bpipta/ENCE_3220_Class2023/PhaseD_Prototype/Notes/Hardware_Block_Diagram.pdf

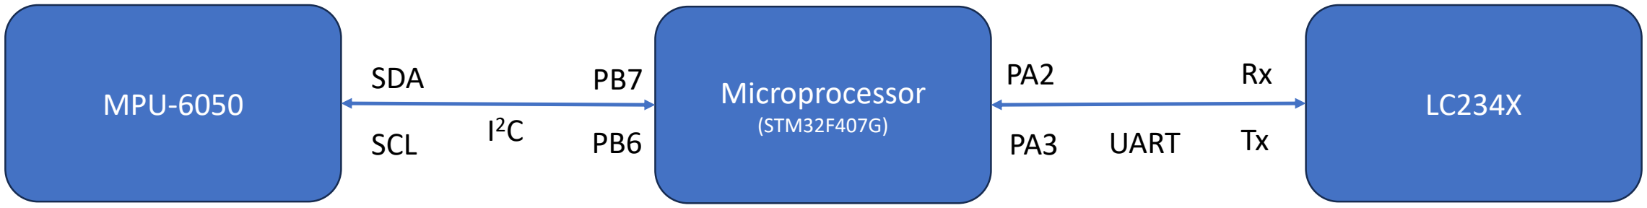
[picture p4: figure]
Microprocessor; (STM32F407G); MPU; SDA; SCL; UART
