bpipta/ENCE_3220_Class2023/PhaseB_Prototype/Notes/Hardware_Block_Diagram.pdf

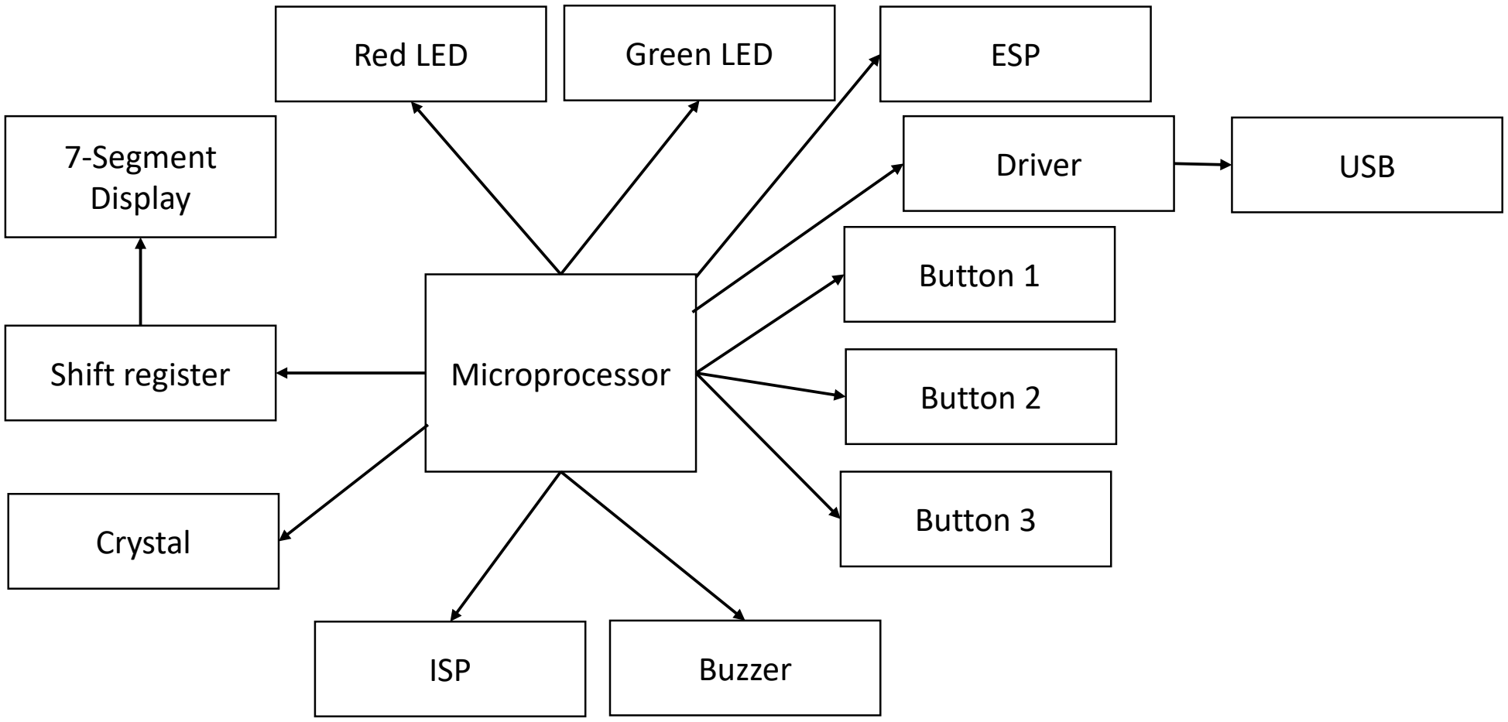
[picture p5: figure]
Microprocessor; 7-Segment Display; Shift register; Red LED; Green LED; Buzzer; Button 1; Button 3; Button 2; ISP; Crystal; ESP; Driver; USB
