bpipta/ENCE_3220_Class2023/PhaseA_Prototype/Notes/Hardware_Block_Diagram.pdf

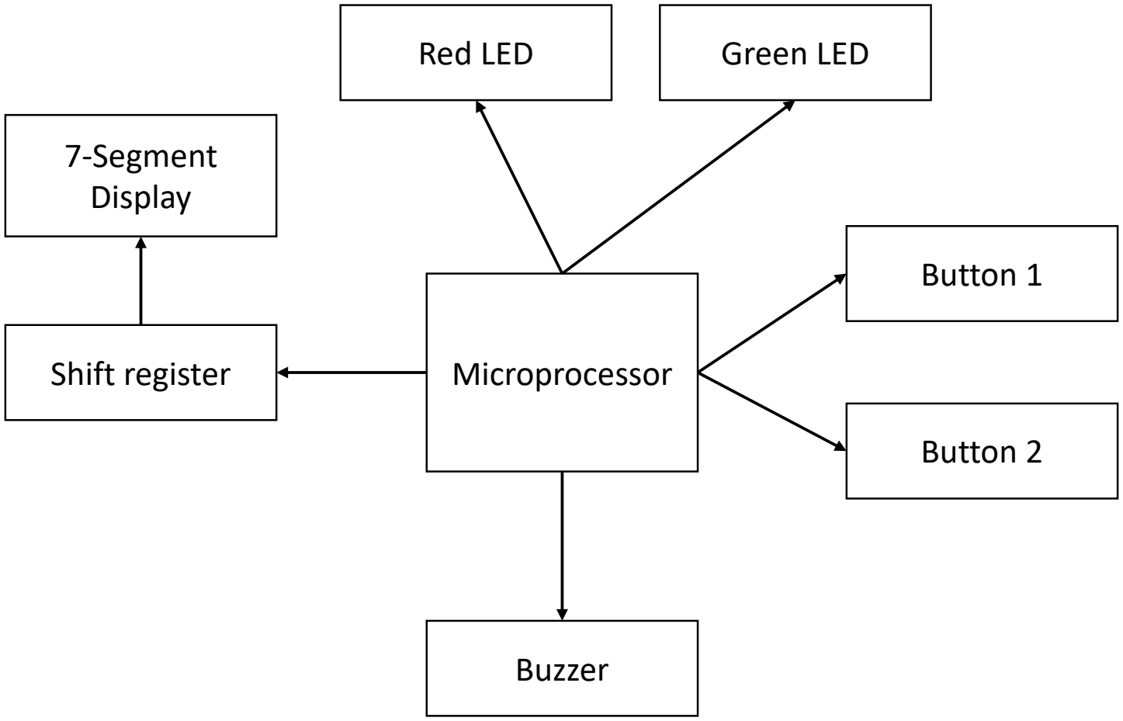
[picture p10: figure]
Microprocessor; 7-Segment Display; Shift register; Red LED; Green LED; Buzzer; Button 1; Button 2
