bpipta/ENCE_3220_Class2023/PhaseB_Prototype/Notes/Code_Block_Diagram.pdf

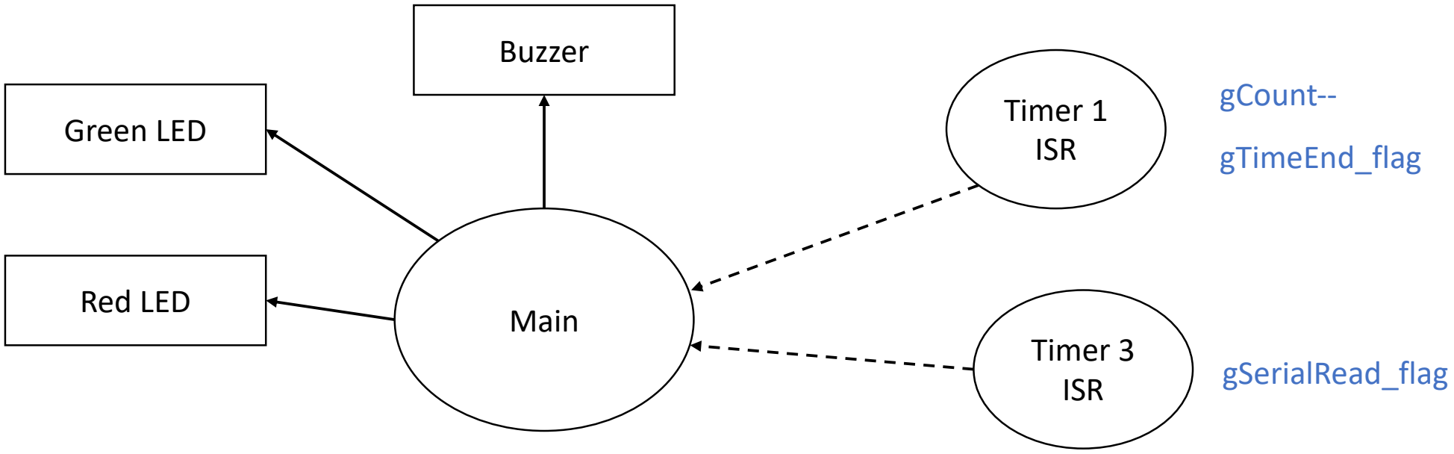
[picture p11: figure]
Main; Timer 1 ISR; Green LED; Red LED; Buzzer; gTimeEnd_flag; gCount--; Timer 3; ISR; gSerialRead_flag

Button 1
ISR

Button 2
ISR

Timer 2
ISR

7 Segment
Display
Start/Stop timer | gCount++
