bpipta/ENCE_3220_Class2023/PhaseD_Prototype/Notes/Software_Block_Diagram.pdf

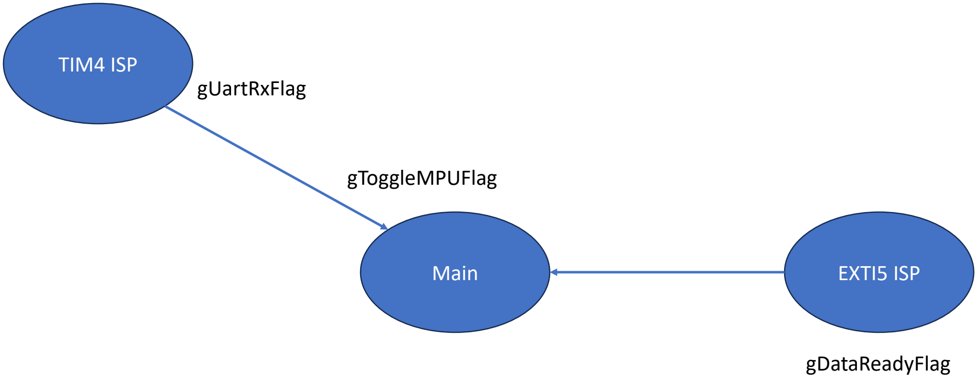
[picture p12: figure]
Main; EXTI5 ISP; TIM4 ISP; gUartRxFlag; gDataReadyFlag; gToggleMPUFlag
