bpipta/ENCE_3220_Class2023/PhaseA_Prototype/Notes/3D_Board.gif

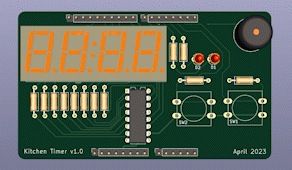
PhaseA_Prototype/Notes/3D_Board.gif
