bpipta/ENCE_3220_Class2023/PhaseA_Prototype/Notes/pcb_layout.png

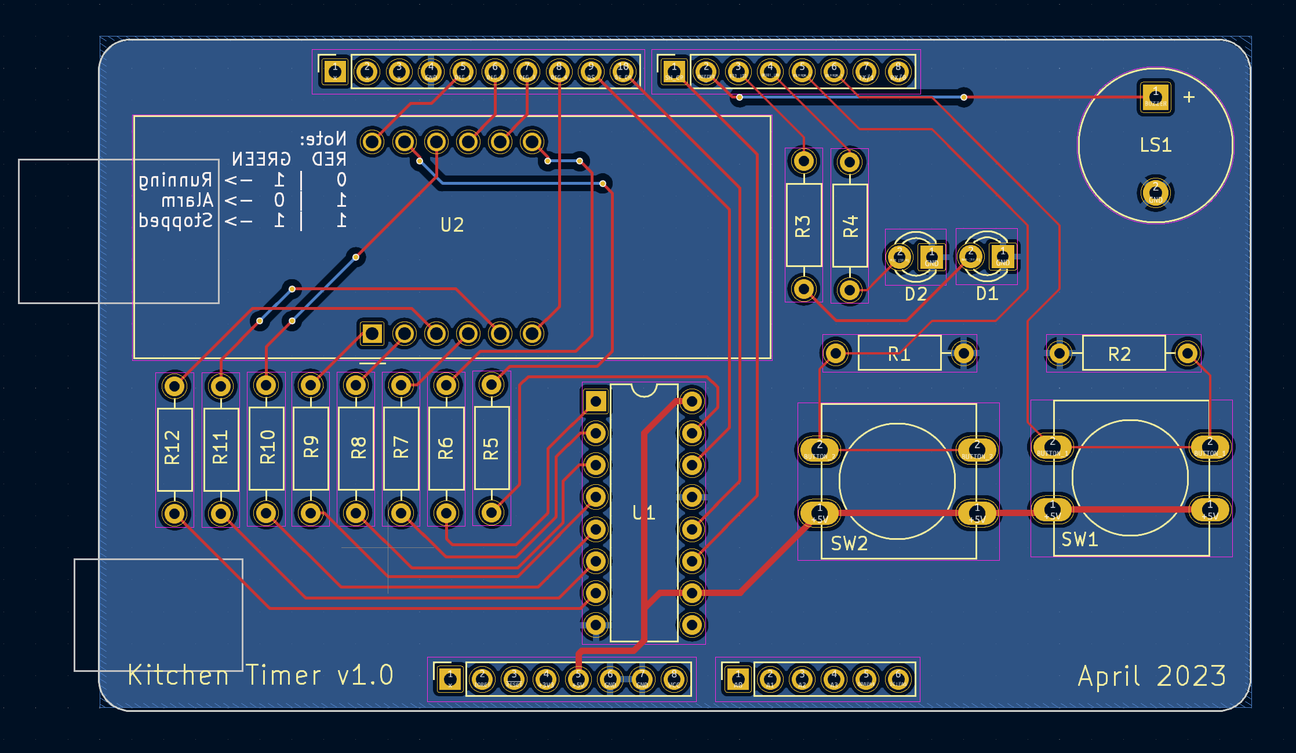
PhaseA_Prototype/Notes/pcb_layout.png
