bpipta/ENCE_3220_Class2023/PhaseA_Prototype/Notes/Proof_of_Concept_Prototype.jpg

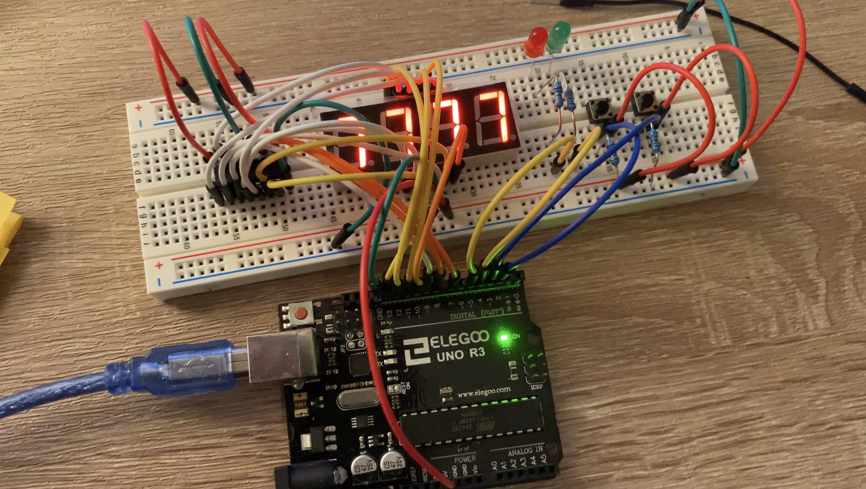
PhaseA_Prototype/Notes/Proof_of_Concept_Prototype.jpg
