bpipta/ENCE_3220_Class2023/PhaseB_Prototype/PCB/plot/pcb_3D_back.png

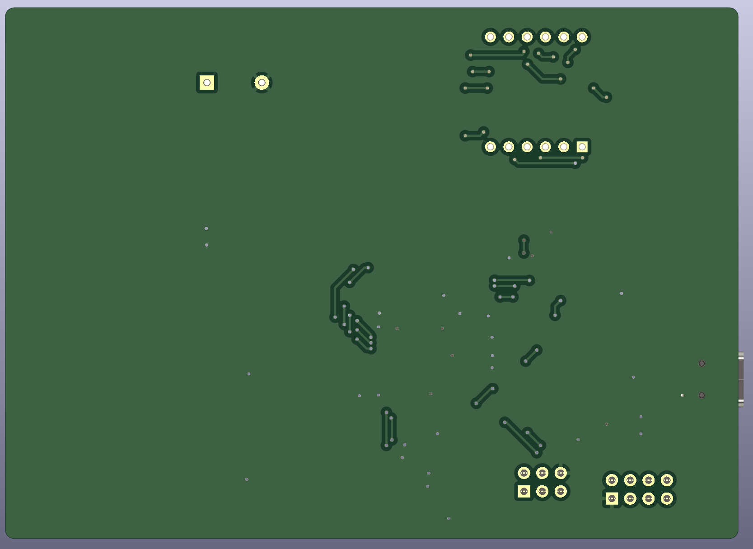
PhaseB_Prototype/PCB/plot/pcb_3D_back.png
