bpipta/ENCE_3220_Class2023/PhaseD_Prototype/Notes/Uart_Serial_Output.gif

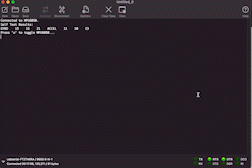
PhaseD_Prototype/Notes/Uart_Serial_Output.gif
