bpipta/ENCE_3220_Class2023/PhaseD_Prototype/PCB/plots/board_back.png

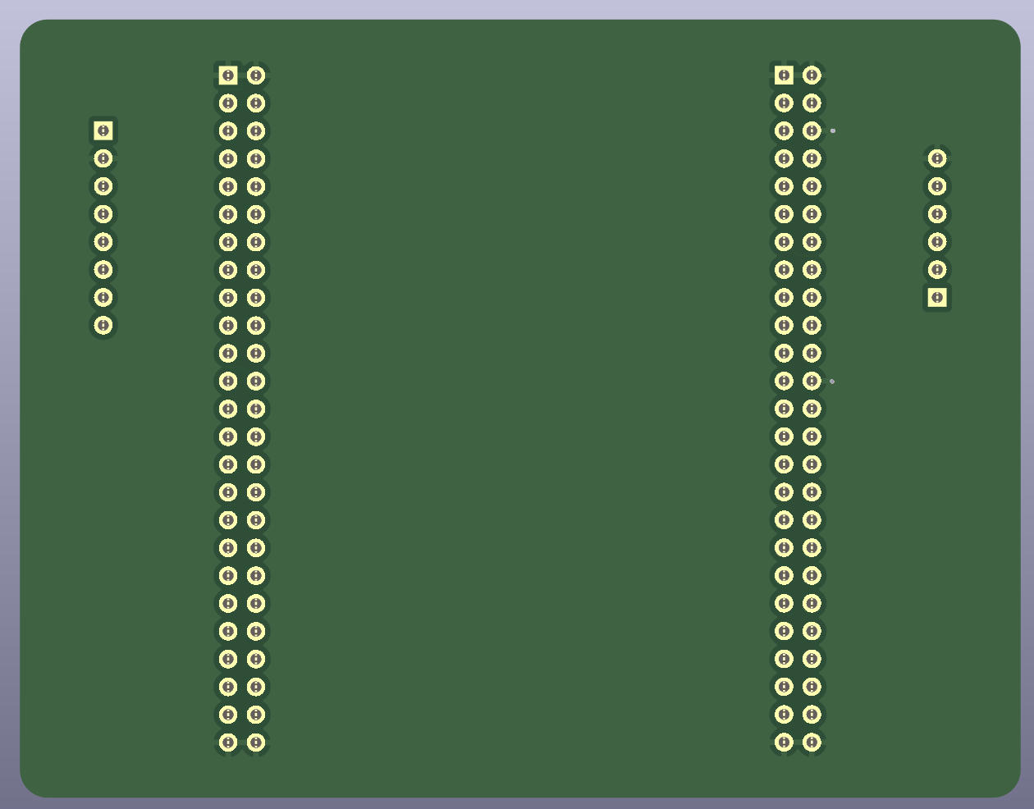
PhaseD_Prototype/PCB/plots/board_back.png
