bpipta/ENCE_3220_Class2023/PhaseB_Prototype/PCB/Components/PTS125_SMD_Button/STEP/PTS125_SMD_Button.stp

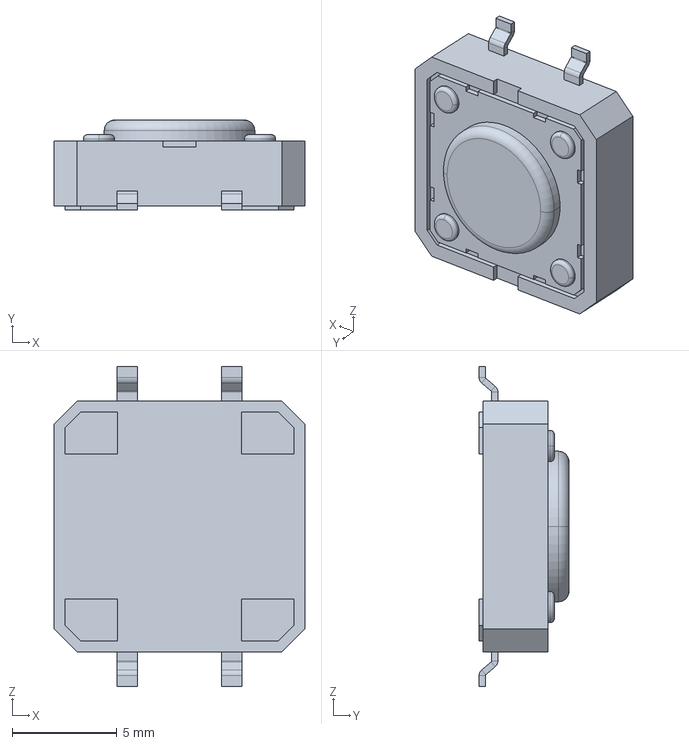
[picture p21: CAD file, 2023-04-12]
PhaseB_Prototype/PCB/Components/PTS125_SMD_Button/STEP/PTS125_SMD_Button.stp
12.0 x 4.30 x 15.3 mm
