bpipta/ENCE_3220_Class2023/PhaseB_Prototype/PCB/Components/PTS526_SMD_Button/STEP/PTS526_SMD_Button.step

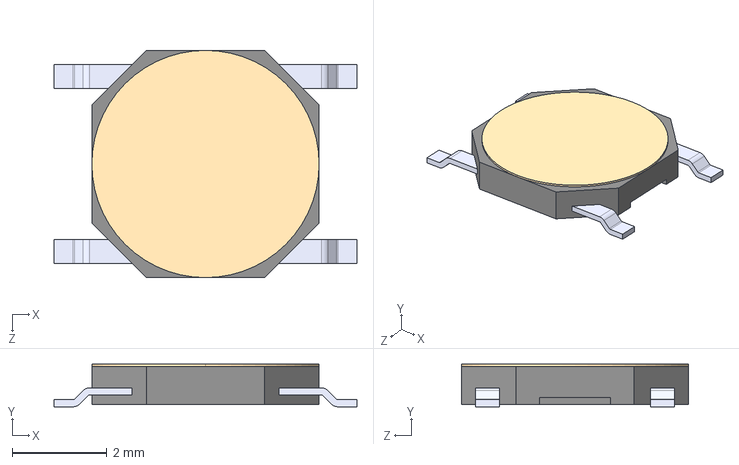
[picture p22: CAD file, 2023-04-12]
PhaseB_Prototype/PCB/Components/PTS526_SMD_Button/STEP/PTS526_SMD_Button.step
6.40 x 0.9 x 4.80 mm
