bpipta/ENCE_3220_Class2023/PhaseB_Prototype/PCB/enclosure/Bottom_Box_PhaseB_Prototype.stl

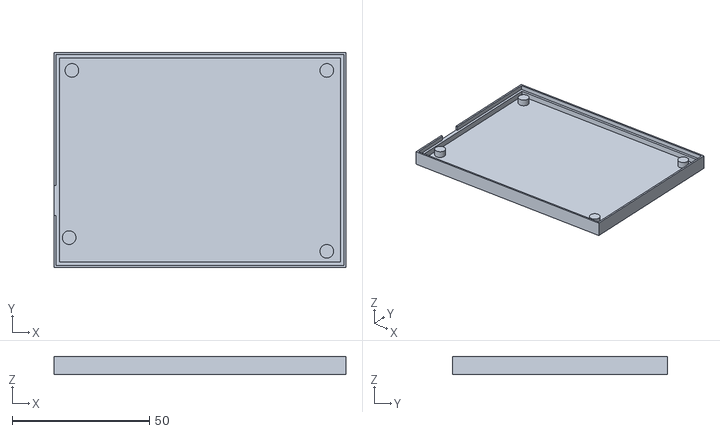
[picture p23: CAD file, 2023-05-04]
PhaseB_Prototype/PCB/enclosure/Bottom_Box_PhaseB_Prototype.stl
106.5 x 78.4 x 6.58
