bpipta/ENCE_3220_Class2023/PhaseB_Prototype/PCB/enclosure/PhaseB_Prototype.step

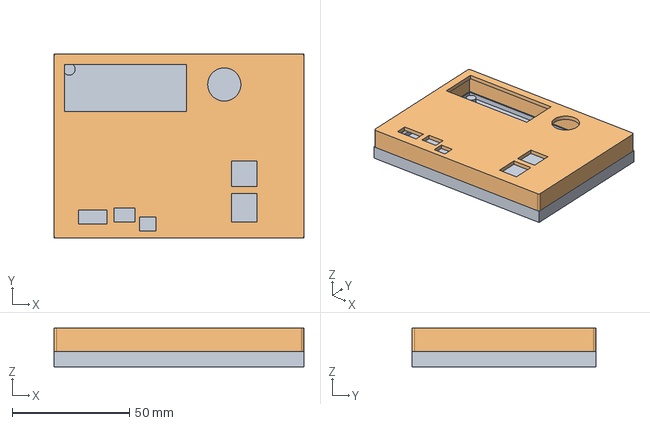
[picture p24: CAD file, 2023-05-04]
PhaseB_Prototype/PCB/enclosure/PhaseB_Prototype.step
106.5 x 78.4 x 16.6 mm
Box_Bottom
Box_Top
