bpipta/ENCE_3220_Class2023/PhaseB_Prototype/PCB/enclosure/Top_Box_PhaseB_Prototype v15.stl

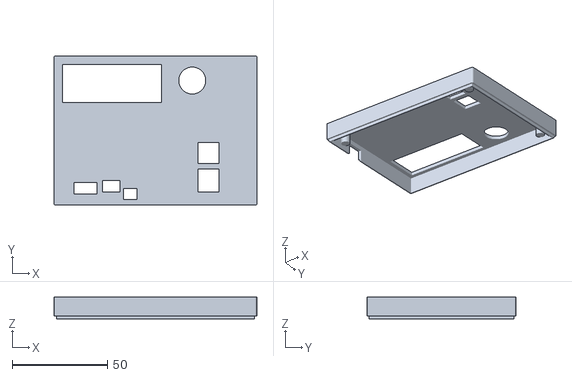
[picture p25: CAD file, 2023-05-04]
PhaseB_Prototype/PCB/enclosure/Top_Box_PhaseB_Prototype v15.stl
106.5 x 78.4 x 11.5
