bpipta/ENCE_3220_Class2023/PhaseB_Prototype/PCB/schematic/PhaseB_Prototype.pdf

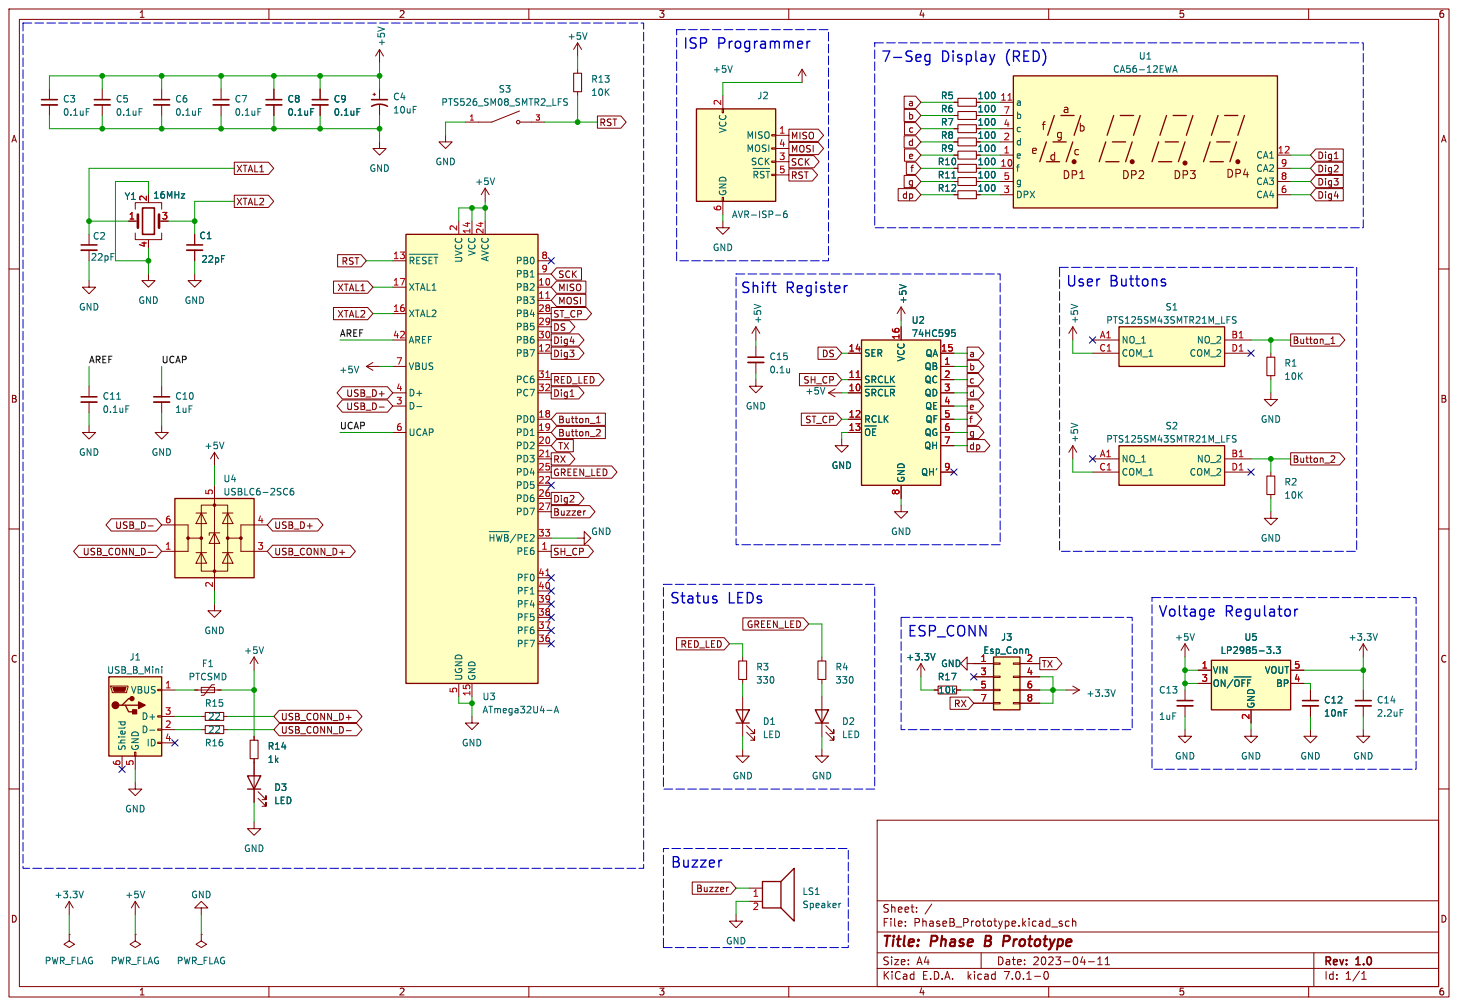
[picture p26: page 1]

2 SCK 3 MOSI 4 ~{RST}5 GND

User Buttons Shift Register
74HC595 GND

2 ON/~{OFF} 3 BP 4 VOUT 5 U5

2 ON/~{OFF} 3 BP 4 VOUT 5 C12

Id: 1/1 Title: Phase B Prototype
