bpipta/ENCE_3220_Class2023/PhaseD_Prototype/PCB/schematic/PhaseD_Prototype.pdf

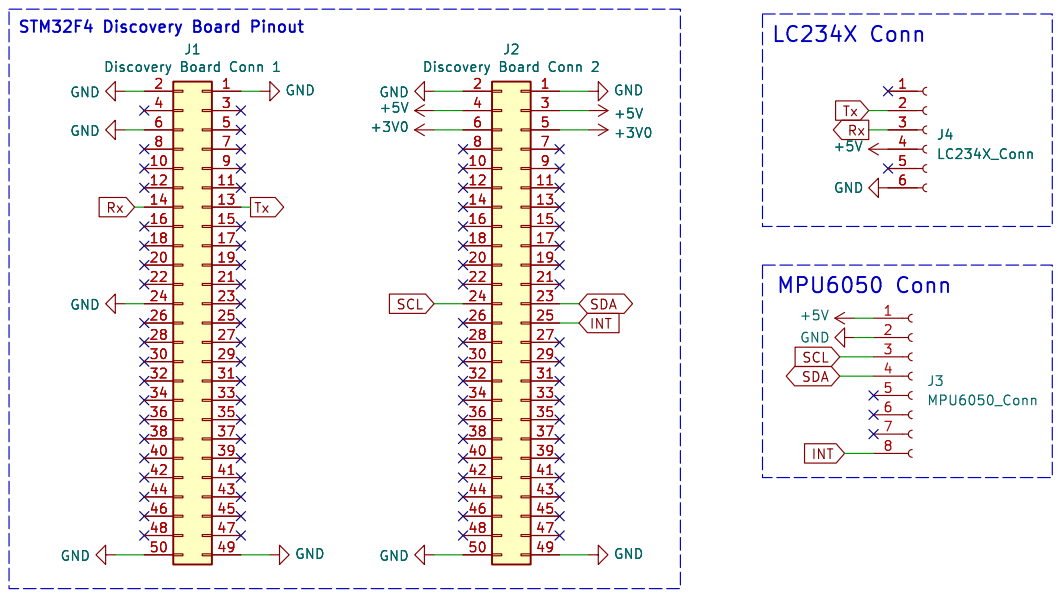
[picture p27: page 1]
