bpipta/ENCE_3220_Class2023/PhaseA_Prototype/PCB/Arduino_Uno_Kitchen_Timer/plots/Arduino_Uno_Kitchen_Timer_Assembly.pdf

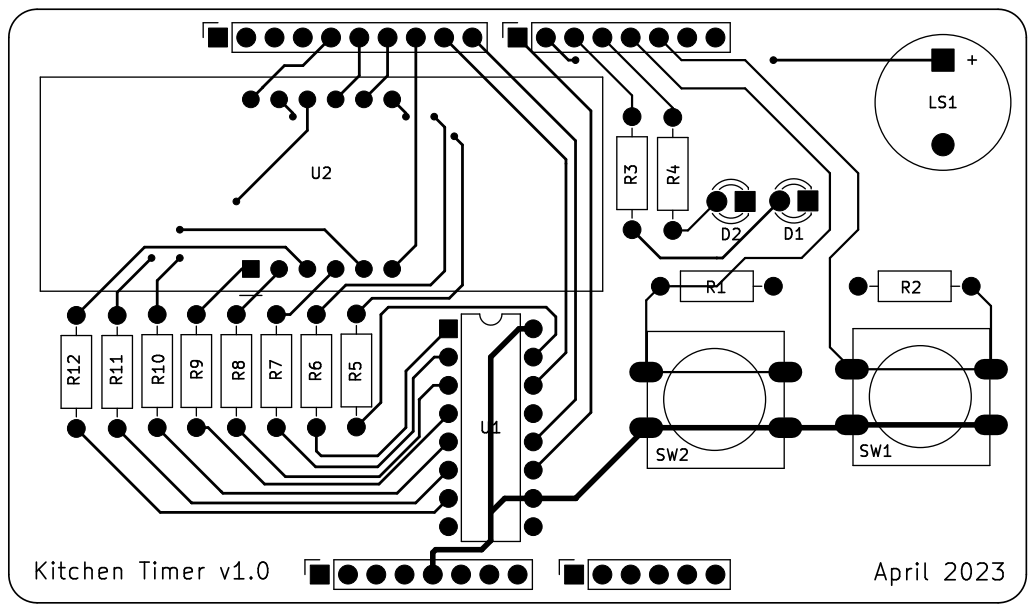
[picture p28: page 1]
