bpipta/ENCE_3220_Class2023/PhaseA_Prototype/PCB/Arduino_Uno_Kitchen_Timer/schematics/Arduino_Uno_Kitchen_Timer.pdf

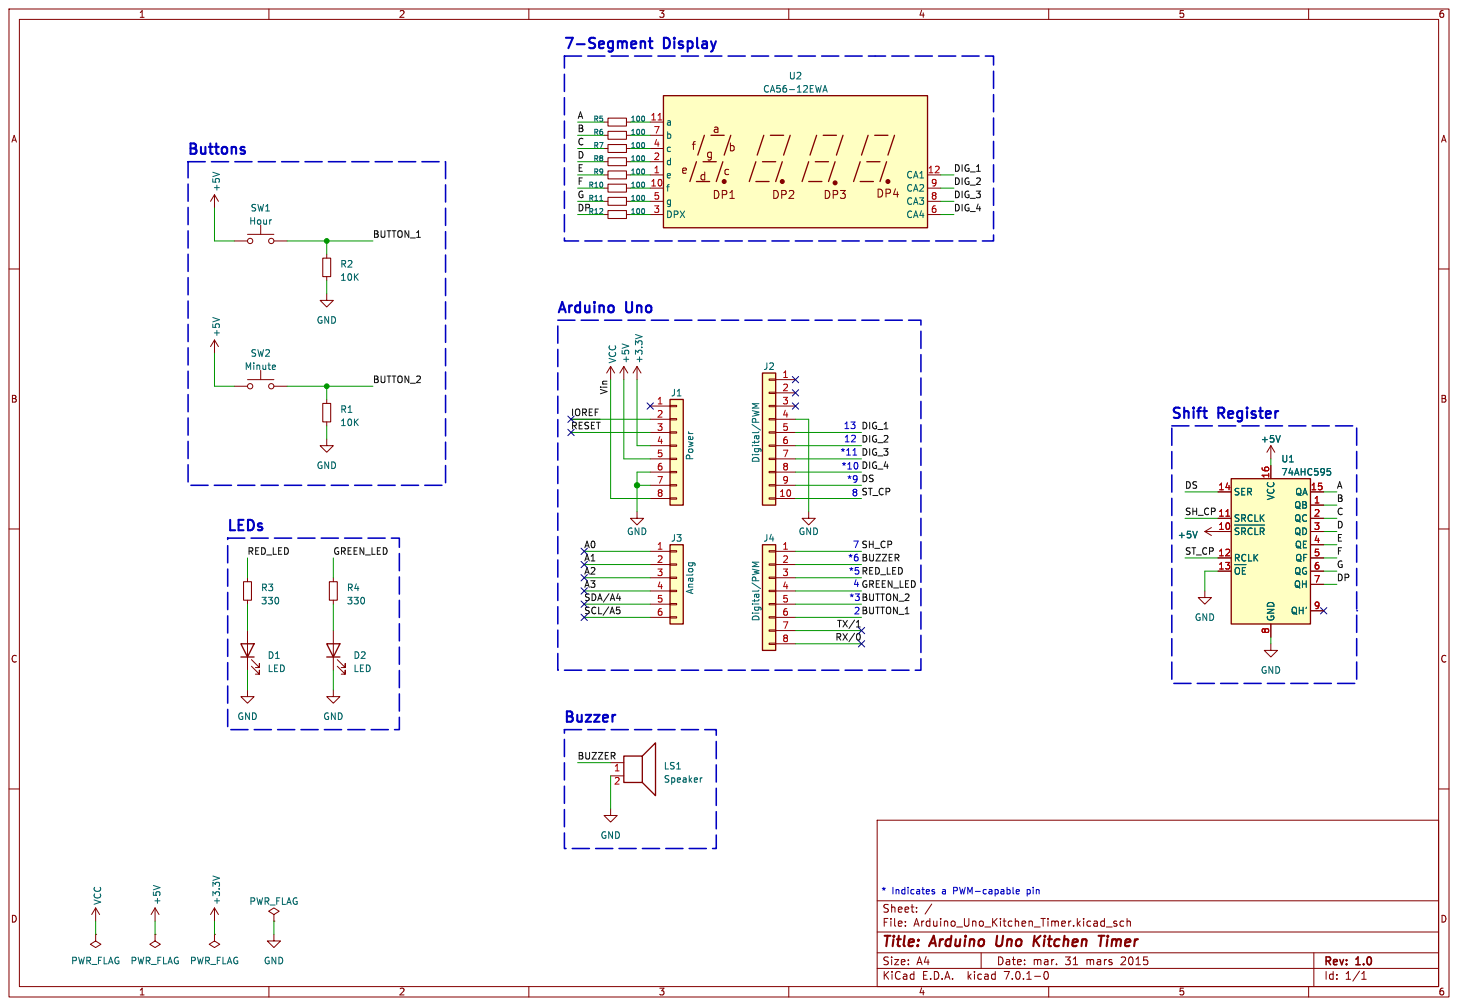
[picture p29: page 1]
