bpipta/ENCE_3220_Class2023/PhaseB_Prototype/PCB/plot/PhaseB_Prototype-F_Cu.pdf

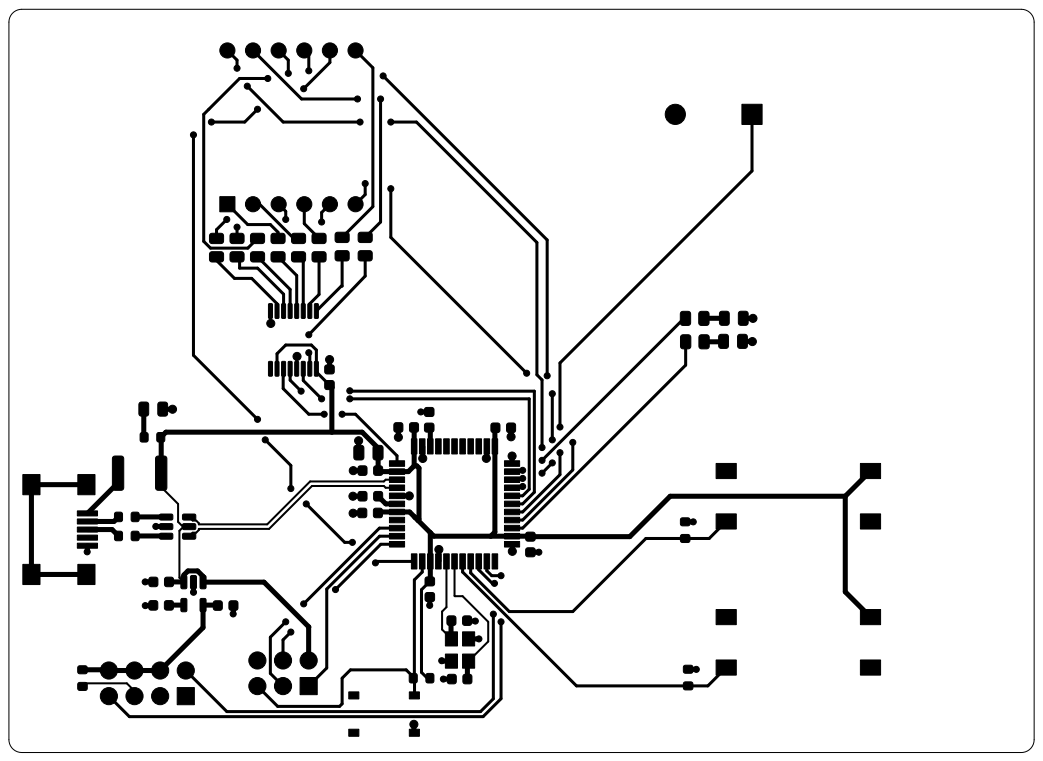
[picture p30: page 1]
