bpipta/ENCE_3220_Class2023/PhaseD_Prototype/PCB/PhaseD_Prototype.kicad_pcb

## KiCad design PhaseD_Prototype/PCB/PhaseD_Prototype.kicad_pcb (2023-05-31)

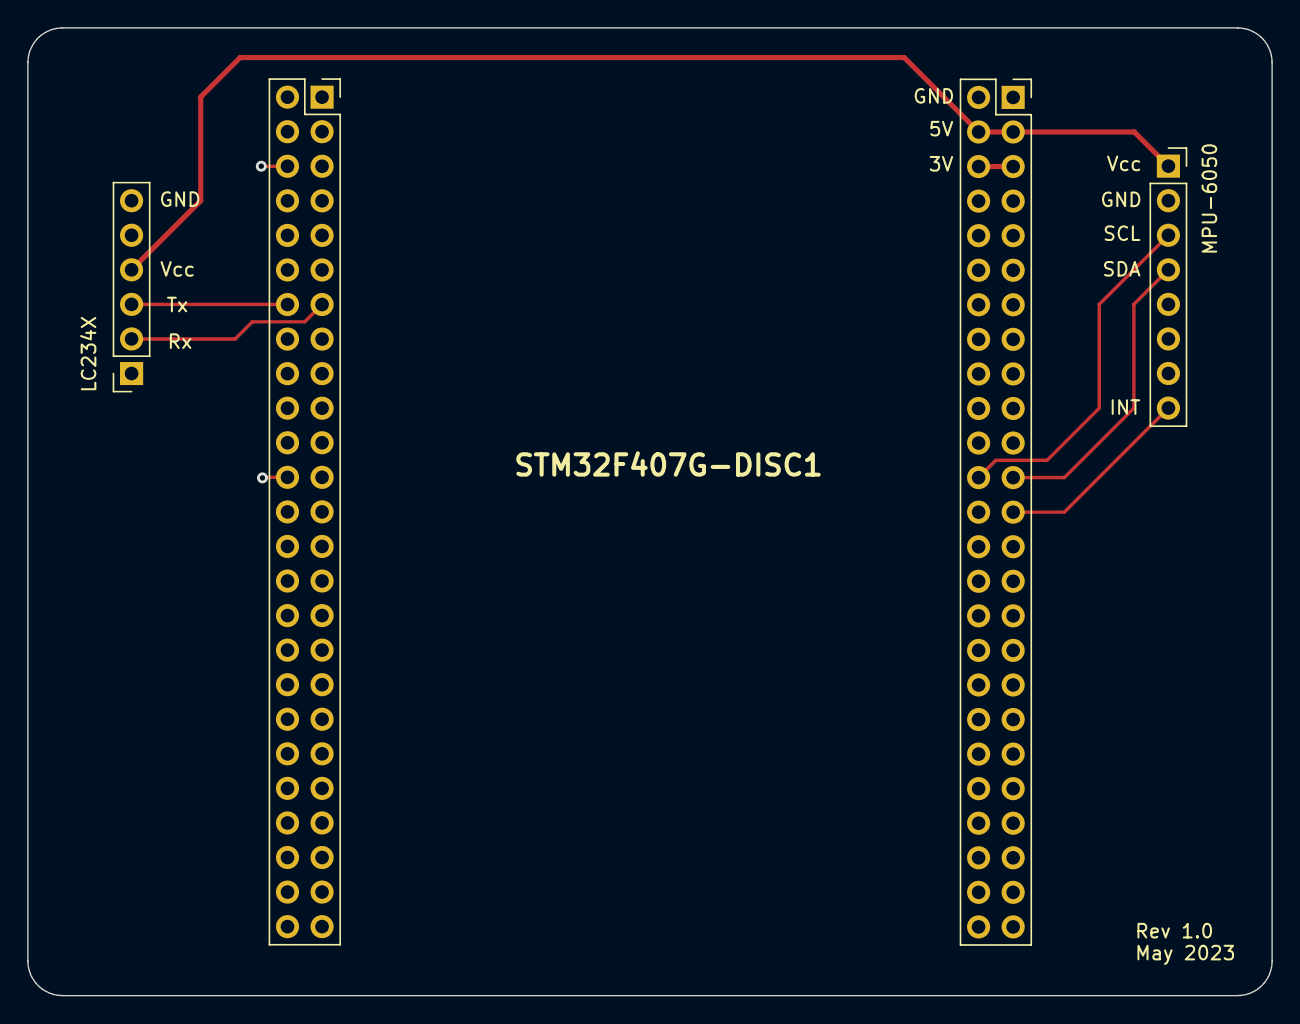
[picture p31: board PhaseD_Prototype.kicad_pcb from above]

Board: 2 copper layers, 91.4 x 71.1 mm, 4 parts (0 on the bottom side), 8 nets.

Parts:
J1: Discovery Board Conn 1; PinSocket_2x25_P2.54mm_Vertical
J2: Discovery Board Conn 2; PinSocket_2x25_P2.54mm_Vertical
J3: MPU6050_Conn; PinSocket_1x08_P2.54mm_Vertical
J4: LC234X_Conn; PinSocket_1x06_P2.54mm_Vertical

Connections:
+3V0: J2.5, J2.6
+5V: J2.3, J2.4, J3.1, J4.4
GND: J1.1, J1.2, J1.6, J1.24, J1.49, J1.50, J2.1, J2.2, J2.49, J2.50, J3.2, J4.6
INT: J2.25, J3.8
Rx: J1.14, J4.3
SCL: J2.24, J3.3
SDA: J2.23, J3.4
Tx: J1.13, J4.2
