bpipta/ENCE_3220_Class2023/PhaseA_Prototype/PCB/Arduino_Uno_Kitchen_Timer/Arduino_Uno_Kitchen_Timer.kicad_pcb

## KiCad design PhaseA_Prototype/PCB/Arduino_Uno_Kitchen_Timer/Arduino_Uno_Kitchen_Timer.kicad_pcb (2023-04-12)

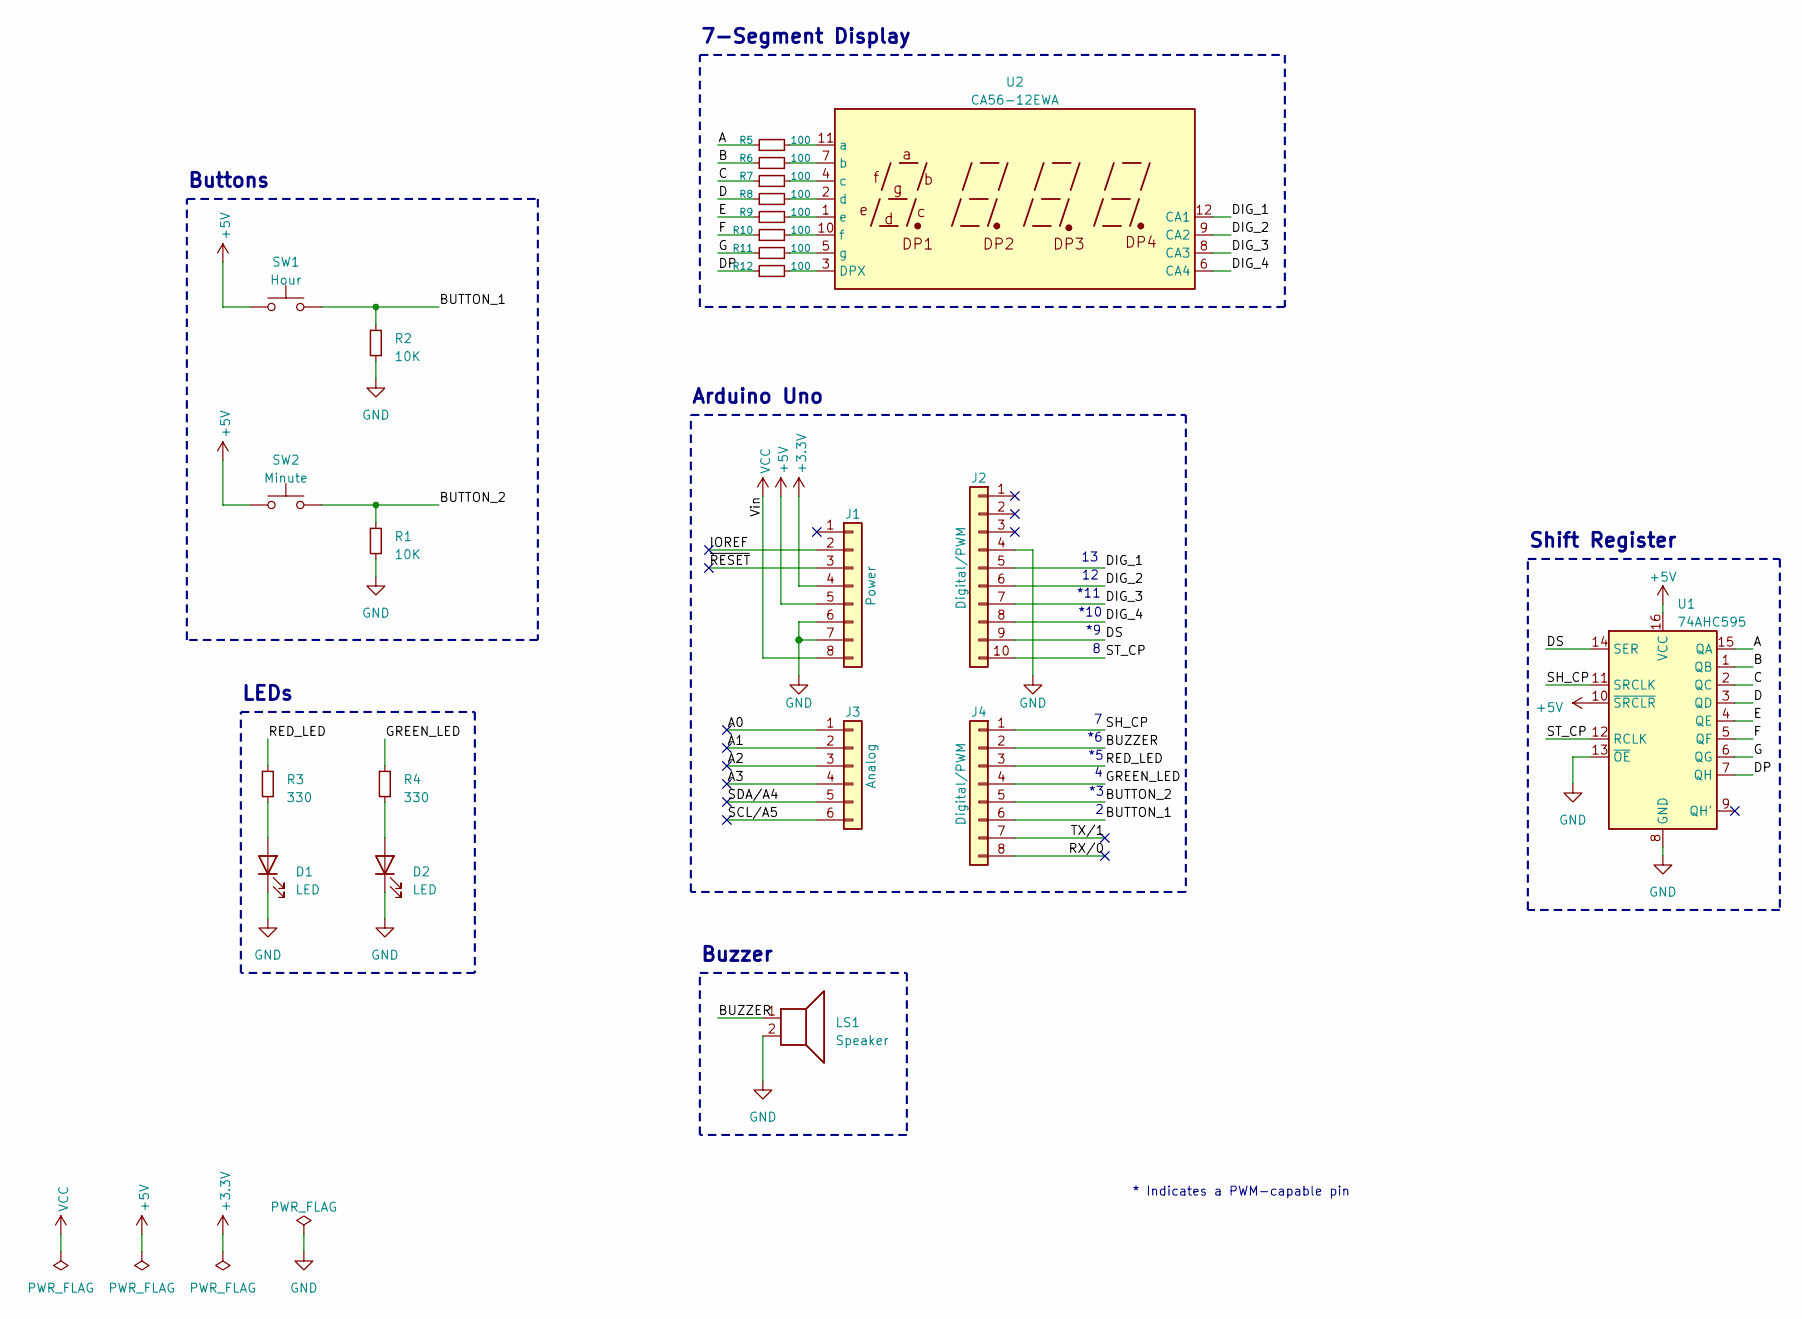
[picture p34: schematic Arduino_Uno_Kitchen_Timer.kicad_sch, Arduino Uno Kitchen Timer]

Parts:
D1, D2: LED; LED_D3.0mm
J1: Power; PinSocket_1x08_P2.54mm_Vertical
J2: Digital/PWM; PinSocket_1x10_P2.54mm_Vertical
J3: Analog; PinSocket_1x06_P2.54mm_Vertical
J4: Digital/PWM; PinSocket_1x08_P2.54mm_Vertical
LS1: Speaker; Buzzer_12x9.5RM7.6
R1, R2: 10K; R_Axial_DIN0207_L6.3mm_D2.5mm_P10.16mm_Horizontal
R3, R4: 330; R_Axial_DIN0207_L6.3mm_D2.5mm_P10.16mm_Horizontal
R5, R6, R7, R8, R9, R10, R11, R12: 100; R_Axial_DIN0207_L6.3mm_D2.5mm_P10.16mm_Horizontal
SW1: Hour; SW_PUSH-12mm
SW2: Minute; SW_PUSH-12mm
U1: 74AHC595; DIP-16_W7.62mm
U2: CA56-12EWA

Connections:
+3V3: J1.4
+5V: J1.5, SW1.1, SW2.1, U1.10 (~SRCLR), U1.16 (VCC)
/A: R5.1, U1.15 (QA)
/A0: J3.1
/A1: J3.2
/A2: J3.3
/A3: J3.4
/B: R6.1, U1.1 (QB)
/BUTTON_1: J4.6, R2.1, SW1.2
/BUTTON_2: J4.5, R1.1, SW2.2
/BUZZER: J4.2, LS1.1
/C: R7.1, U1.2 (QC)
/D: R8.1, U1.3 (QD)
/DIG_1: J2.5, U2.12 (CA1)
/DIG_2: J2.6, U2.9 (CA2)
/DIG_3: J2.7, U2.8 (CA3)
/DIG_4: J2.8, U2.6 (CA4)
/DP: R12.1, U1.7 (QH)
/DS: J2.9, U1.14 (SER)
/E: R9.1, U1.4 (QE)
/F: R10.1, U1.5 (QF)
/G: R11.1, U1.6 (QG)
/GREEN_LED: J4.4, R4.1
/IOREF: J1.2
/RED_LED: J4.3, R3.1
/RX/0: J4.8
/SCL/A5: J3.6
/SDA/A4: J3.5
/SH_CP: J4.1, U1.11 (SRCLK)
/ST_CP: J2.10, U1.12 (RCLK)
/TX/1: J4.7
/~RESET: J1.3
GND: D1.1 (K), D2.1 (K), J1.6, J1.7, J2.4, LS1.2, R1.2, R2.2, U1.8 (GND), U1.13 (~OE)
unnamed: D1.2 (A), R3.2
unnamed: D2.2 (A), R4.2
unnamed: R12.2, U2.3 (DPX)
unnamed: R5.2, U2.11 (a)
unnamed: R6.2, U2.7 (b)
unnamed: R7.2, U2.4 (c)
unnamed: R8.2, U2.2 (d)
unnamed: R9.2, U2.1 (e)
unnamed: R10.2, U2.10 (f)
unnamed: R11.2, U2.5 (g)
VCC: J1.8

Notes on the sheet:
Shift Register
*11
Arduino Uno
7-Segment Display
*10
* Indicates a PWM-capable pin
LEDs
Buzzer
Buttons

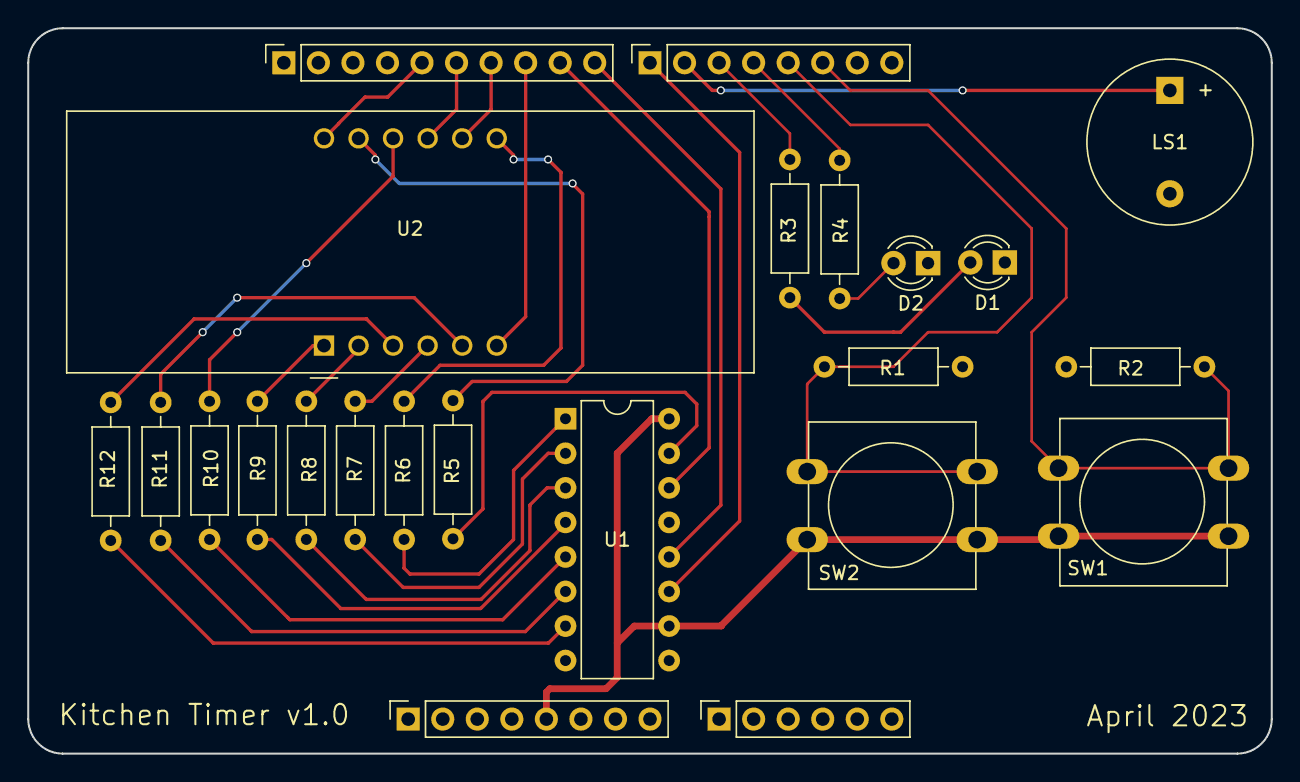
[picture p35: board Arduino_Uno_Kitchen_Timer.kicad_pcb from above]

Board: 2 copper layers, 91.4 x 53.3 mm, 23 parts (0 on the bottom side), 32 nets.
