bpipta/ENCE_3220_Class2023/(commit log)

2023-04-12 Completed Phase A: Kitchen Timer v1.0
    [Arduino_Uno_Kitchen_Timer-B_Cu.gbr, Arduino_Uno_Kitchen_Timer-B_Mask.gbr, Arduino_Uno_Kitchen_Timer-B_Paste.gbr, Arduino_Uno_Kitchen_Timer-B_Silkscreen.gbr, Arduino_Uno_Kitchen_Timer-Edge_Cuts.gbr, Arduino_Uno_Kitchen_Timer-F_Cu.gbr, Arduino_Uno_Kitchen_Timer-F_Mask.gbr, Arduino_Uno_Kitchen_Timer-F_Paste.gbr]
2023-04-12 Initial commit for Phase B
    [PTS125_SMD_Button.stp, PTS526_SMD_Button.step, PhaseB_Prototype.kicad_pcb, PhaseB_Prototype.kicad_sch]
2023-04-13 Completed schematic for Phase B
    [PhaseB_Prototype.kicad_pcb, PhaseB_Prototype.kicad_sch]
2023-04-21 Completed PCB for Phase B
    [PTS125_SMD_Button.stp, PTS526_SMD_Button.step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]
2023-04-21 Renamed pcb screenshots
2023-04-27 Added 3d models to buttons on PhaseB PCB
    [PhaseB_Prototype.kicad_pcb]
2023-05-04 Completed Phase B Beta
    [Bottom_Box_PhaseB_Prototype.stl, PhaseB_Prototype.step, Top_Box_PhaseB_Prototype v15.stl]
2023-05-31 Work on Phase D Prototype
    [PhaseD_Prototype-B_Cu.gbr, PhaseD_Prototype-B_Mask.gbr, PhaseD_Prototype-B_Paste.gbr, PhaseD_Prototype-B_Silkscreen.gbr, PhaseD_Prototype-Edge_Cuts.gbr, PhaseD_Prototype-F_Cu.gbr, PhaseD_Prototype-F_Mask.gbr, PhaseD_Prototype-F_Paste.gbr]
